wamiquemohd/Fuel-Cell-System/Load Specification/Load Specification sheet.xlsx

Sr No. | Components | List | Current(Amps) |  | Voltage(V) | Power |  | Comment
 |  |  | Nominal (Amps) | Peak (Amps) |  | Nominal (W) | Peak (W)
1 | Communication | Gps | 0.19 | 0.58 | 5V to 15V | 2.9 | 2.9
2 | Sensor | Ultra sonic sensor | 0.002 | 0.006 | 5 | 0.01 | 0.03
 |  | IR sensor | 0.02 | 0.04 | 5 | 0.1 | 0.2
 |  | Accelerometer | 2.2e-05 | 2.2e-05 | 3.3 | 7.26e-05 | 7.26e-05
 |  | LiDAR Ouster OS1 | 0.833 | 1.66 | 12V to 24V | 20 | 20 | https://elli.hs-bremerhaven.de/goto.php?target=file_293596_download&client_id=elli
3 | Motor | Motor 1 (100W to 250W) @24V | 4.1 | 10.4 | 24 | 98.4 | 249.6
 |  | Motor 2 (100W to 250 W) @24V | 4.1 | 10.4 | 24 | 98.4 | 249.6
4 | Camera | R&D Drone Thermal Camera | 0.333 | 1.33 | 9V to 36V | 12 | 12 | https://elli.hs-bremerhaven.de/goto.php?target=file_293595_download&client_id=elli
 |  | MultiSpectral Camera Micasense | 0.48 | 1.71 | 7V to 25.2V | 12 | 12 | Cosidered12W mode https://elli.hs-bremerhaven.de/goto.php?target=file_293597_download&client_id=elli
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
