wamiquemohd/Fuel-Cell-System/Procurement List/Procurement_List_071222_Final.xlsx

Procurement List (Cells with Green color - Item Procured)
ReqID | Module | Supplier | No of units | Cost | Delivery Time | LINK | Comments
Req.024 | bq76920EVM: µC-Controlled AFE Family for 3s-5s-Series Cell Li-Ion and Phosphate Evaluation Module | Texas Instrument | 1 minumum | Digikey: 181.36 Euro Mouser: 198.17 | 2-4 days | Digikey_BQ76920 (https://eu.mouser.com/ProductDetail/Texas-Instruments/BQ76920EVM?qs=Mrfp3zus3mMJ05wfgDY%2Fvg%3D%3D) | Procured on 01.12.2022
Req.024 | DollaTek Battery BMS Board Module Li-Ion Li-Polymer Battery Pack Protective Board BMS for 13S 48V / 54.6V Batteries | AMAZON | 2 | 13 Euro | 1-2 Days | 13s BMS Amazon (https://www.amazon.de/-/en/DollaTek-Battery-Li-Polymer-Protective-Batteries/dp/B083PSYGSN) | Procured on 15.11.2022
Req.024 | 4Series 30A 14.8V BMS PCB Battery Protective Board with Balance Function for 18650 Li-Ion Lithium Battery Cell with Wire | AMAZON | 2 | 8 Euro | 1-2 Days | 4s BMS Amazon (https://www.amazon.de/-/en/4Series-Battery-Protective-Balance-Function-black-green/dp/B075296PDZ) | Procured on 17.11.2022
Req.024 | Voltage Current Module, 0-36V 20A Current Sensor Module | AMAZON | 1 | 20 Euro | 1-2 Days | Current Sensor Module (https://www.amazon.de/-/en/INA226-Voltage-Current-Module-Monitoring/dp/B08MKYT54F) | Procured on 31.11.2022
 | Dollatek MAX3232 RS232 Serial Port To TTL Converter Module DB9 Connector W/4 Jump Cables | AMAZON | 1 | €5.99 | 1-2 Days | https://www.amazon.de/Dollatek-MAX3232-RS232-Serial-Converter-Module-DB9-Connector/dp/B07DK3874B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
NA | XT60 connector | AMAZON | 1 | 8 Euro | 1-2 Days | XT60 connector (https://www.amazon.de/-/en/RUNCCI-YUN-pieces-pairs-connectors-female/dp/B07N1N2C94) | Procured on 30.11.22
Req.001 | Wacent Power Supply Module, Electronic Component, Durable Accessory, DC-DC 10-60V to 12-97V 1500W 30A Voltage Up Converter Boost CC CV | AMAZON | Minimum 1 | 39.29 Euro | 5 working day | https://www.amazon.de (https://www.amazon.de/Electronic-Component-Durable-Accessory-Converter/dp/B08KG6CFX2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) | Need to Procure
Req.002 | ANGEEK 300W 20A DC-DC Converter Module Step Down Voltage Module Constant Current Adjustable Buck Converter | AMAZON | Minimum 1 | 12.99 Euro | 5 working day | https://www.amazon.de (https://www.amazon.de/-/en/Converter-Voltage-Constant-Current-Adjustable/dp/B07RGWJHPZ) | Need to Procure
Req.003 | AZDelivery LM2596S DC-DC Power Supply Adapter Step Down Module Compatible with Arduino Includes eBook | AMAZON | Minimum 1 | 3.99 Euro | 5 working day | https://www.amazon.de (https://www.amazon.de/-/en/AZDelivery-LM2596S-DC-DC-Power-Supply/dp/B089QJM8KQ) | Need to Procure
Req.004 | Swetup Schottky Diode 30 A 50 V Axial 30SQ050 for Solar Panel Parallel Reflow Protection Diodes Silicone Diodes Barrier High Voltage Diode Rectifier for Electronic Components Pack of 20 | AMAZON | Minimum 4 | 9.99 Euro(Pack of 20) | 5 working day | https://www.amazon.de (https://www.amazon.de/-/en/Schottky-Protection-Rectifier-Electronic-Components/dp/B0BFL6R5W9) | Need to Procure
Req.005 | AZDelivery ESP32 NodeMCU Module WLAN WiFi Dev Kit C Development Board with CP2102 (Successor Model to ESP8266) Compatible with Arduino and Includes E-Book | AMAZON | Minimum 1 | 9.99 Euro | 5 working day | https://www.amazon.de (https://www.amazon.de/-/en/dp/B071P98VTG/ref=twister_B07Z6CSD9K?_encoding=UTF8&psc=1) | Need to Procure
Req.006 | DC-DC 4-38V to 1.25-36V Voltage Adjustable Converter XL4015 Buck High Power Buck Converter 5A | AMAZON | 1 | €3.29 Euro | 1-2 Days | https://www.amazon.de (https://www.amazon.de/Allayu-1-25-36V-Voltage-Adjustable-Converter/dp/B09GXYQCKJ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) | Need to Procure
Req.007 | Relay, JQC-3F(T73)-5VDC 5P Coil Voltage: DC 5V | AMAZON | 1*4 | €9.19 (5X) | MAx. 1 week | https://www.amazon.de (https://www.amazon.de/Appliances-Network-Communications-Electronic-Devices/dp/B07QWP14MV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) | Need to Procure
Req.008 | Resistor, 100 Ohm | AMAZON | 2*4 | €6.49 (100 pcs. x) | 1 weeks | https://www.amazon.de (https://www.amazon.de/POPESQ%C2%AE-Widerstand-Verwendbar-Metall-A2405/dp/B07KX4PTFK?hvadid=427726028372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) | Need to Procure
Req.009 | Resistor,10K | AMAZON | 4*4 | €6.49 (100 pcs. x) | 1 weeks | https://www.amazon.de (https://www.amazon.de/POPESQ%C2%AE-Widerstand-Verwendbar-Metall-A2428/dp/B07KX4YVY3?hvadid=447550395739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) | Need to Procure
Req.010 | Resistor,1K | AMAZON | 1*4 | €6.49 (100 pcs. x) | 1 week | https://www.amazon.com (https://www.amazon.com/Projects-10EP5121K00-Ohm-Resistors-Pack/dp/B0185FK65K) | Need to Procure
Req.011 | LED, Red/Green... | AMAZON | 2*4 | €7.99 mixed kit 10 colours | 1 week | https://www.amazon.de (https://www.amazon.de/St%C3%BCck-Diffus-Dioden-Gemischte-Farben/dp/B06XPV4CSH?hvadid=310418504392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) | Need to Procure
Req.012 | Diode, 1N4007 | AMAZON | 1*4 | €6.50 (100pcs) | 1 weeks | https://www.amazon.de (https://www.amazon.de/dp/B08JY7DJYD?s=ce-de&sp_csd=d2lkZ2V0TmFtZT1zcF9kZXRhaWw) | Need to Procure
Req.013 | Transitor,transistor P channel MOSFET IRF9540 MOSFET | AMAZON | 2*4 | €4.99 Pack of 10 | 1 weeks | https://www.amazon.de (https://www.amazon.de/BOJACK-IRF9540-Transistoren-IRF9540N-Leistungs/dp/B086YW4TPD?hvadid=474061214378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) | Need to Procure
Req.014 | Connector, 2pins/3 Pins 2.54 mm Pitch PCB Mount Screw Terminal Block | AMAZON | 1*4 3pin 6*4 2Pin | €9.99 100 Pieces 5 mm 2 Pin / 3 Pin | 1 weeks | https://www.amazon.de (https://www.amazon.de/-/en/YIXISI-Pieces-Terminal-Connector-Arduino/dp/B087RN8FDZ?s=industrial) | Need to Procure
Req.015 | Diode, 1N4733A | AMAZON | 2*4 | €4.99 Pack of 100 | 1 week | https://www.amazon.de (https://www.amazon.de/Packung-100-Chanzon-1N4733A-DO-204AL/dp/B079KHSFN5) | Need to Procure
Req.016 | Transitor,BC547 Transistor | AMAZON | 3*4 | €5.70 20 Pcs. x | 1 weeks | https://www.amazon.de (https://www.amazon.de/POPESQ%C2%AE-Stk-BC547-Transistor-pcs/dp/B07DR8VGZ7?hvadid=500836261436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) | Need to Procure
Req.017 | Heatsink, TO-220 Heatsink Aluminum Cooling Insulator Mounting Kit for MOSFET Transistor TO-220 | AMAZON | 2*4 | €7.99 | 1 weeks | https://www.amazon.de (https://www.amazon.de/-/en/Xiatiaosann-Heatsink-Insulator-Transistor-20mmx15mm/dp/B09PH4GM1D?s=industrial) | Need to Procure
Req.022 | Dual MOSFET Switching Module 400W High-Power - 5 Pieces Trigger Switch Drive Module, DC 5V-36V 15A | AMAZON | 1 set(5 modules) | 9.99 Euro | 1-2 Days | PMC Link (https://www.amazon.de/Dual-MOSFET-Switching-Module-High-Power/dp/B092D3YZK3?sp_csd=d2lkZ2V0TmFtZT1zcF9hdGY) | Procured on 28.11.22
Req.025 | CC CV Step Down Module Adjustable DC 6-40V to 1.2-36V Voltage Regulator Down Converter Constant Current Power Supply Module | AMAZON | 1 | 9 Euro | 1-2 Days | Charger 0-60V (https://www.amazon.de/-/en/Adjustable-1-2-36V-Regulator-Converter-Constant/dp/B09DYDRZF5) | Need to Procure
Req.025 | DC 6.5-36V 24V Step Down to DC 1.2V-32V 12V Volt Transformer Reducer 4.5A 75W CC CV Power Supply Module | AMAZON | 1 | 15 Euro | 1-2 Days | 0-36V Charger (https://www.amazon.de/-/en/Converter-ZHITING-Regulator-1-2V-32V-Transformer/dp/B08NJ87DBQ) | Need to Procure
