wamiquemohd/Fuel-Cell-System/Fuel Cell System Design/System Design V3 [Wamique].pdf

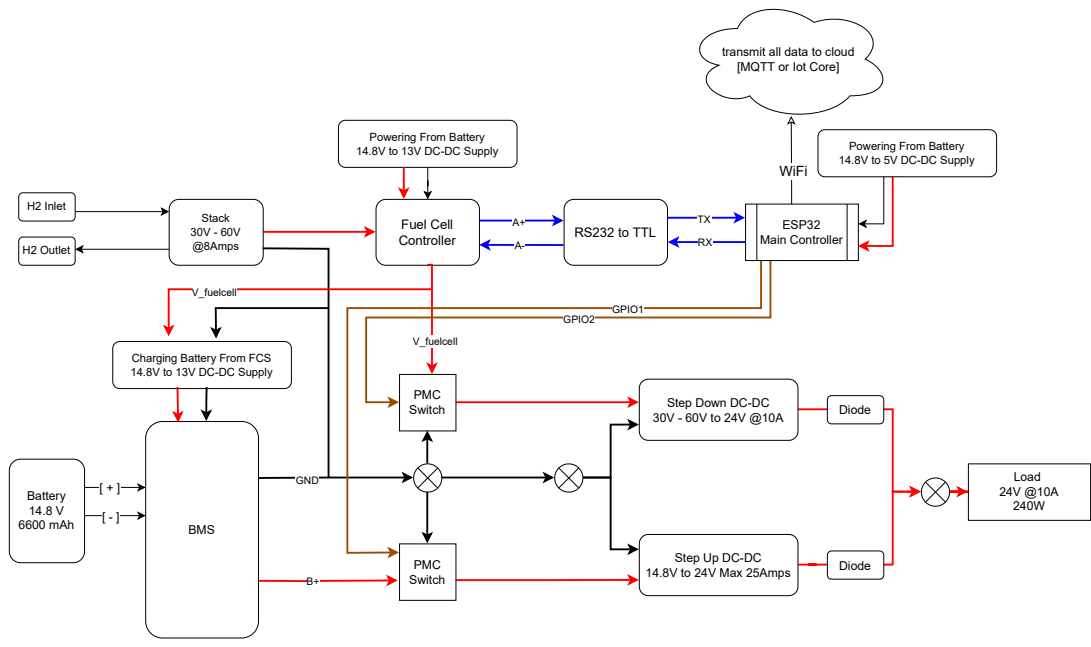
[picture p4: page 1]
Stack 30V - 60V @8Amps; H2 Inlet; H2 Outlet; Fuel Cell Controller; Battery 14.8 V; 6600 mAh; BMS; PMC Switch; Load 24V @10A 240W; WiFi; ESP32; V_fuelcell; GND; GPIO2; GPIO1; Diode

transmit all data to cloud
[MQTT or Iot Core]

Powering From Battery
14.8V to 13V DC-DC Supply

14.8V to 5V DC-DC Supply

Main Controller RS232 to TTL

Charging Battery From FCS

Step Down DC-DC

Step Up DC-DC
14.8V to 24V Max 25Amps
