wamiquemohd/Fuel-Cell-System/Fuel Cell System Design/System Design V2 [Wamique].pdf

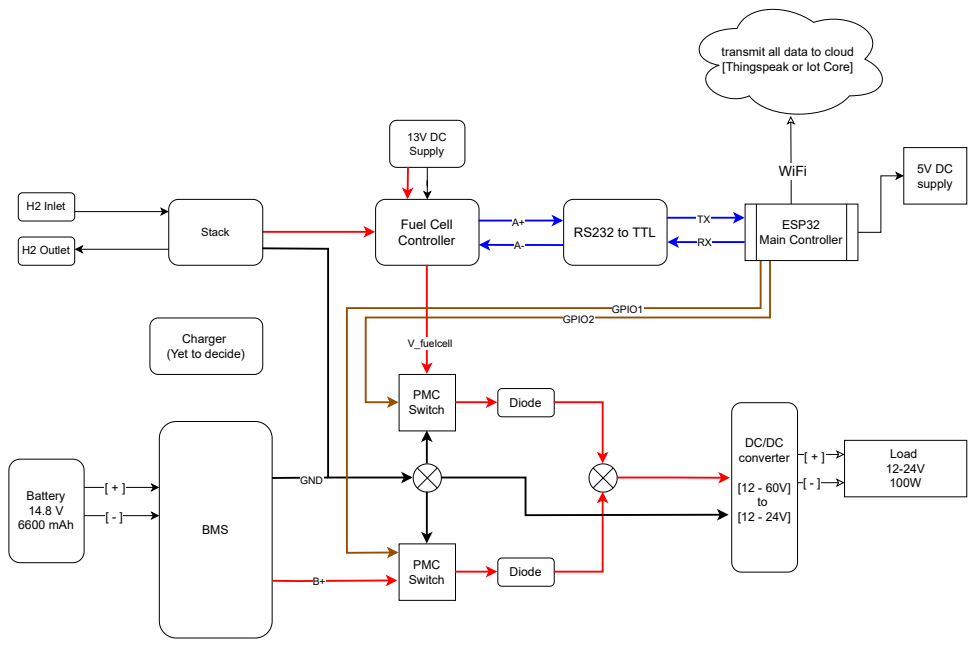
[picture p5: page 1]
Stack; H2 Inlet; H2 Outlet; 13V DC Supply; Fuel Cell Controller; Battery 14.8 V; 6600 mAh; BMS; PMC Switch; Load 12-24V 100W; DC/DC converter; Diode; WiFi; ESP32; V_fuelcell; GND; GPIO2; GPIO1; 5V DC supply

transmit all data to cloud
[Thingspeak or Iot Core]

Main Controller RS232 to TTL

Charger
(Yet to decide)
