wamiquemohd/Fuel-Cell-System/(commit log)

2022-12-08 Updated the code for fcc to mcu
    [Load Specification sheet.xlsx]
2022-12-15 Updated requirement sheet
    [Requirement Sheet v8.xlsx, Requirement Sheet.xlsx]
2022-12-15 Added Procurement List
    [Procurement_List_071222_Final.xlsx, Requirement Sheet.xlsx]
